wigand-mj/led-matrix/README.md

# led-matrix
Simple arduino controlled led matrix with snake game
