wigand-mj/led-matrix/schematics/EXPORT/MATRIX.PNG

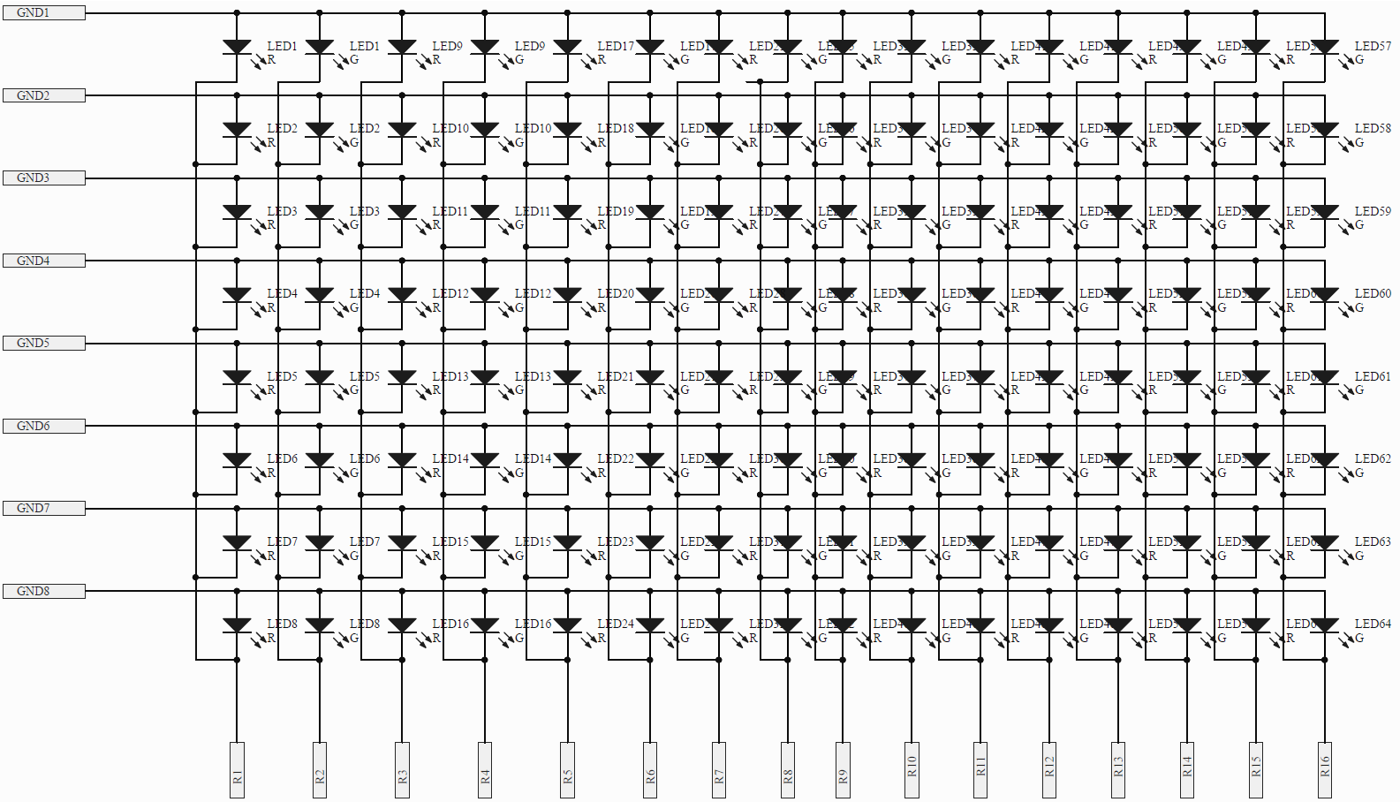
schematics/EXPORT/MATRIX.PNG
