wigand-mj/led-matrix/schematics/EXPORT/MATRIX_FIXED.PNG

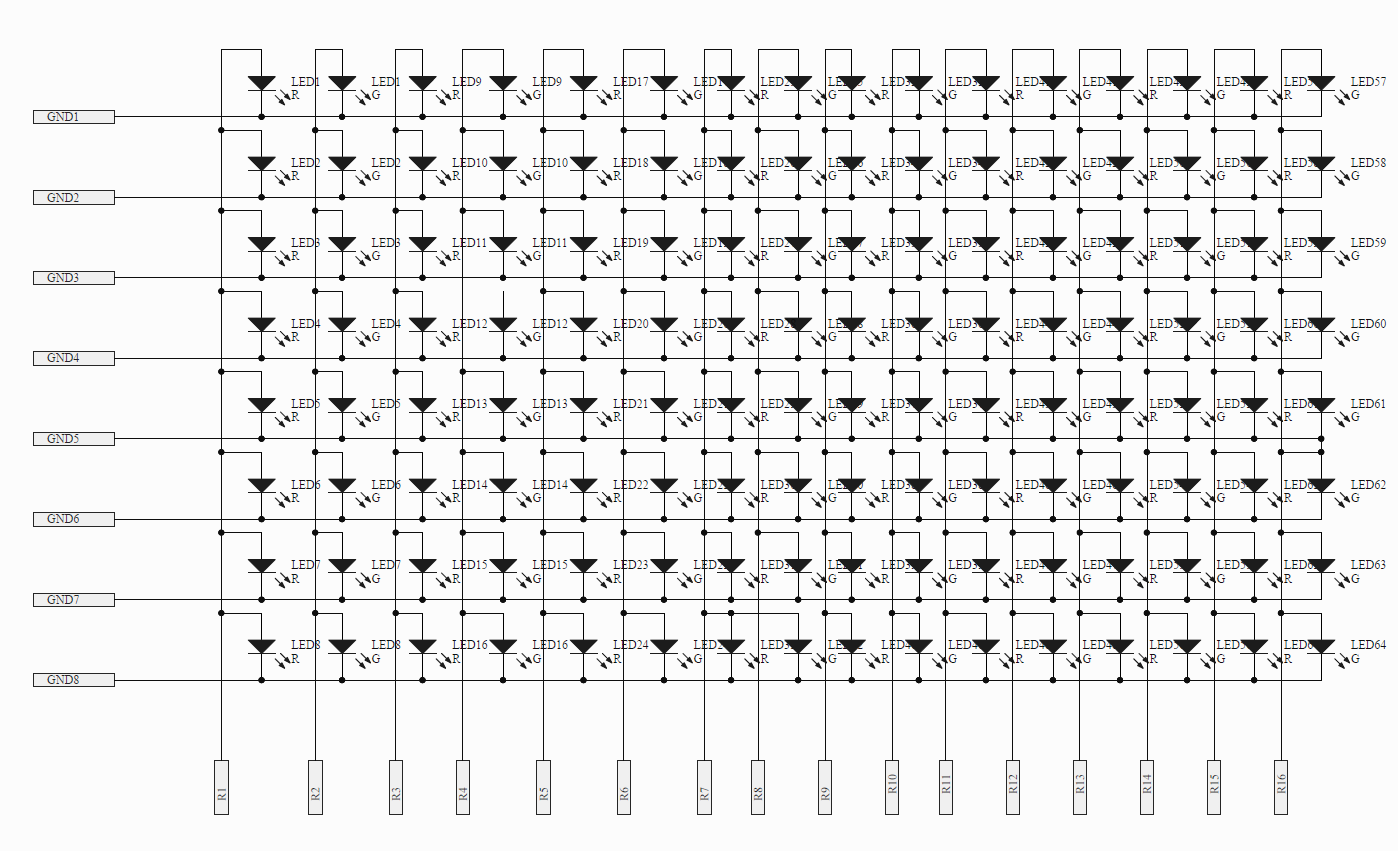
schematics/EXPORT/MATRIX_FIXED.PNG
