wigand-mj/led-matrix/schematics/LED_MATRIX_SCHEMATIC/Sheet1.pdf

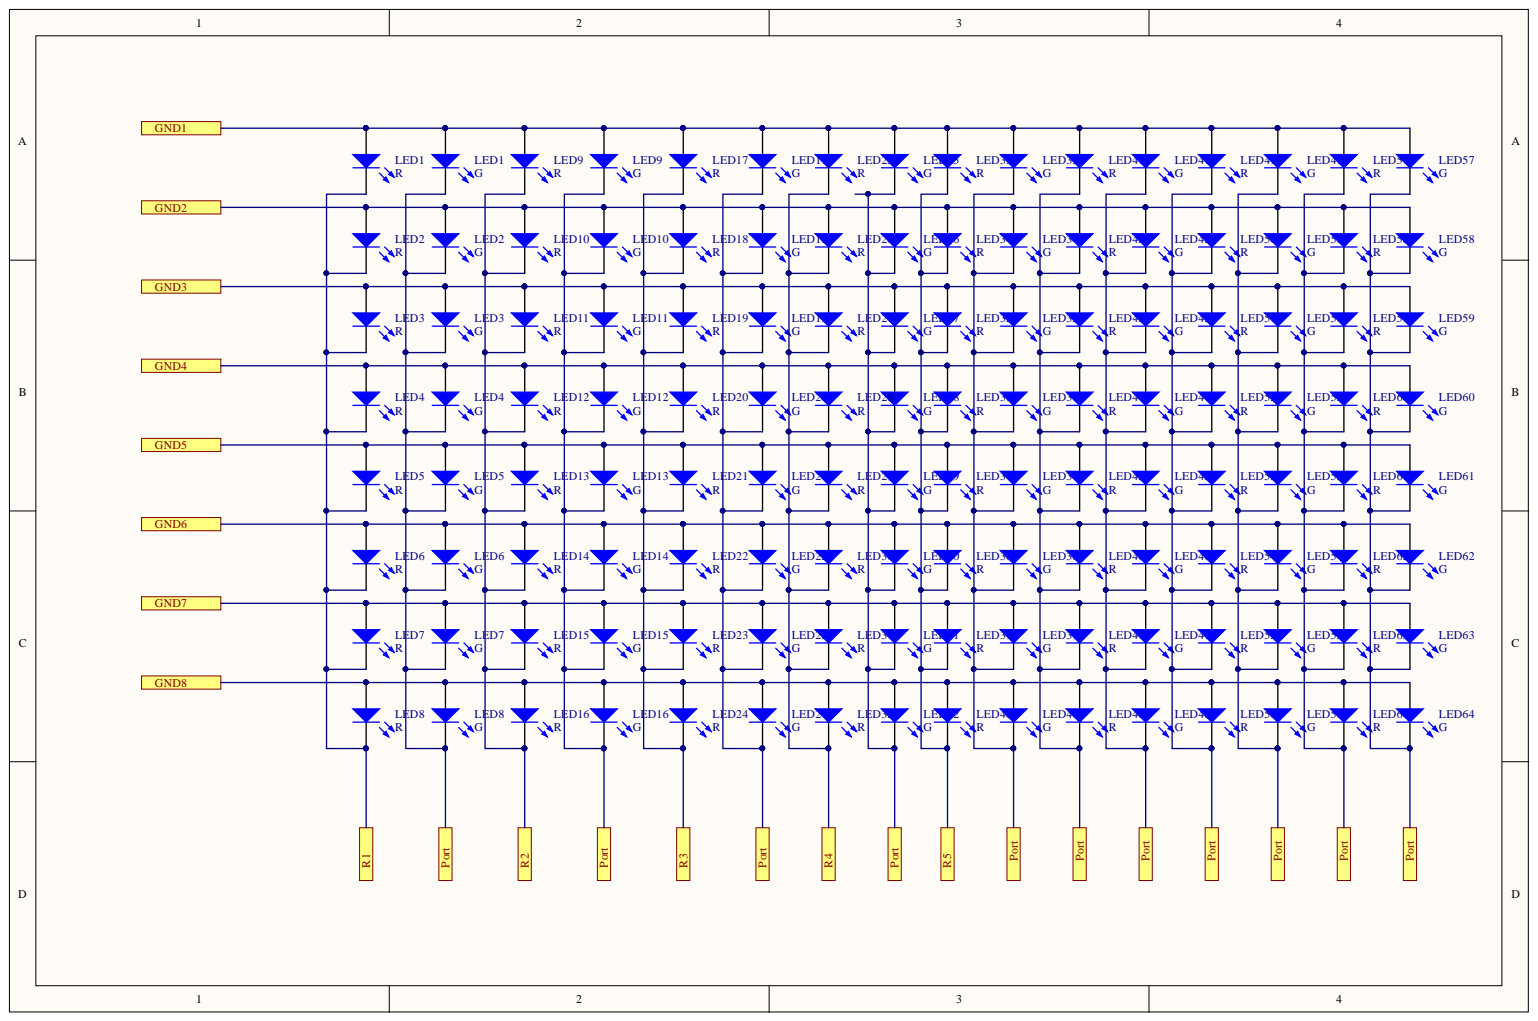
[picture p13: page 1]

# Board Stack Report
