wigand-mj/led-matrix/schematics/LED_MATRIX_SCHEMATIC/Sheet1_2.pdf

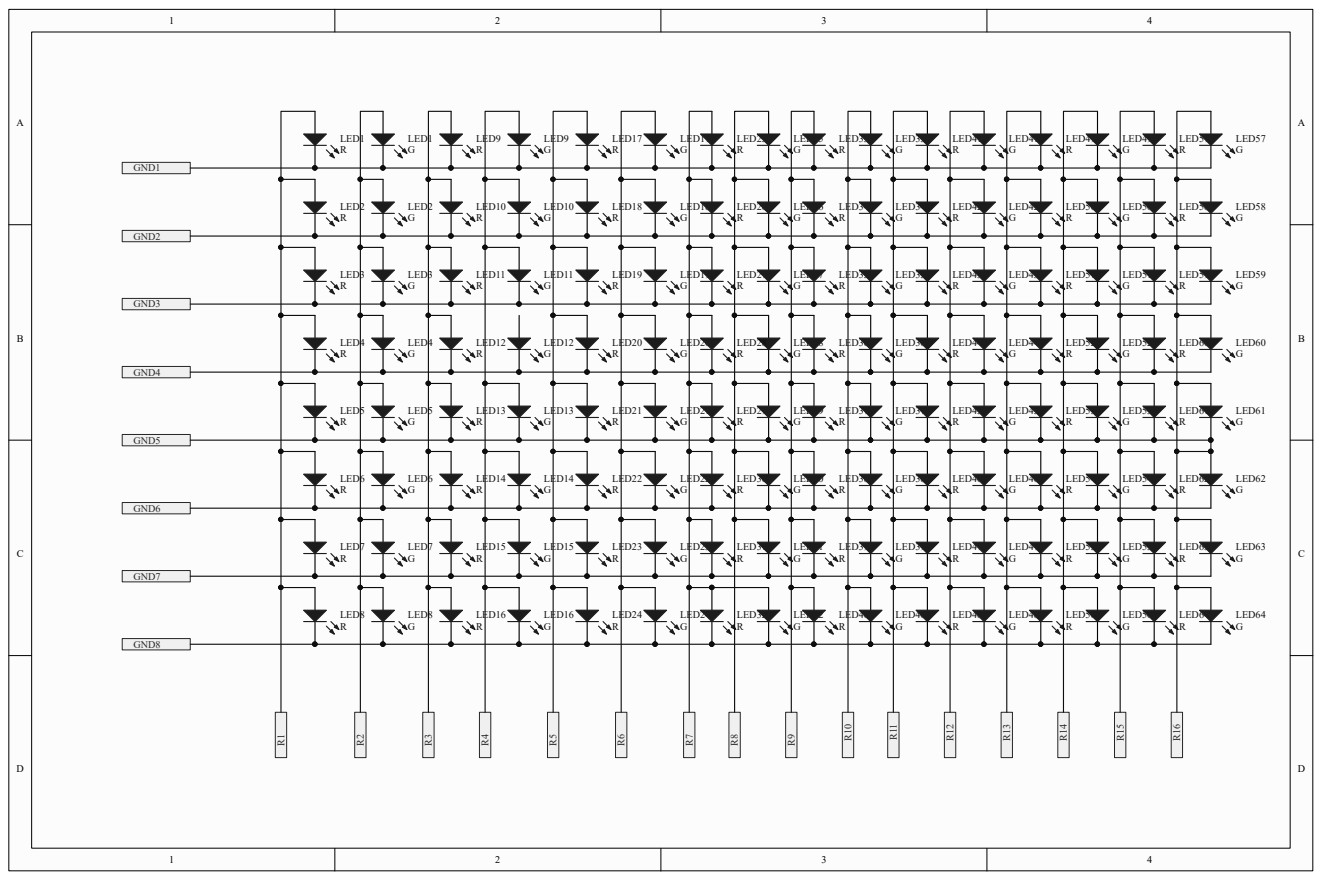
[picture p14: page 1]
