wigand-mj/led-matrix/schematics/LED_MATRIX_SCHEMATIC/pd.pdf

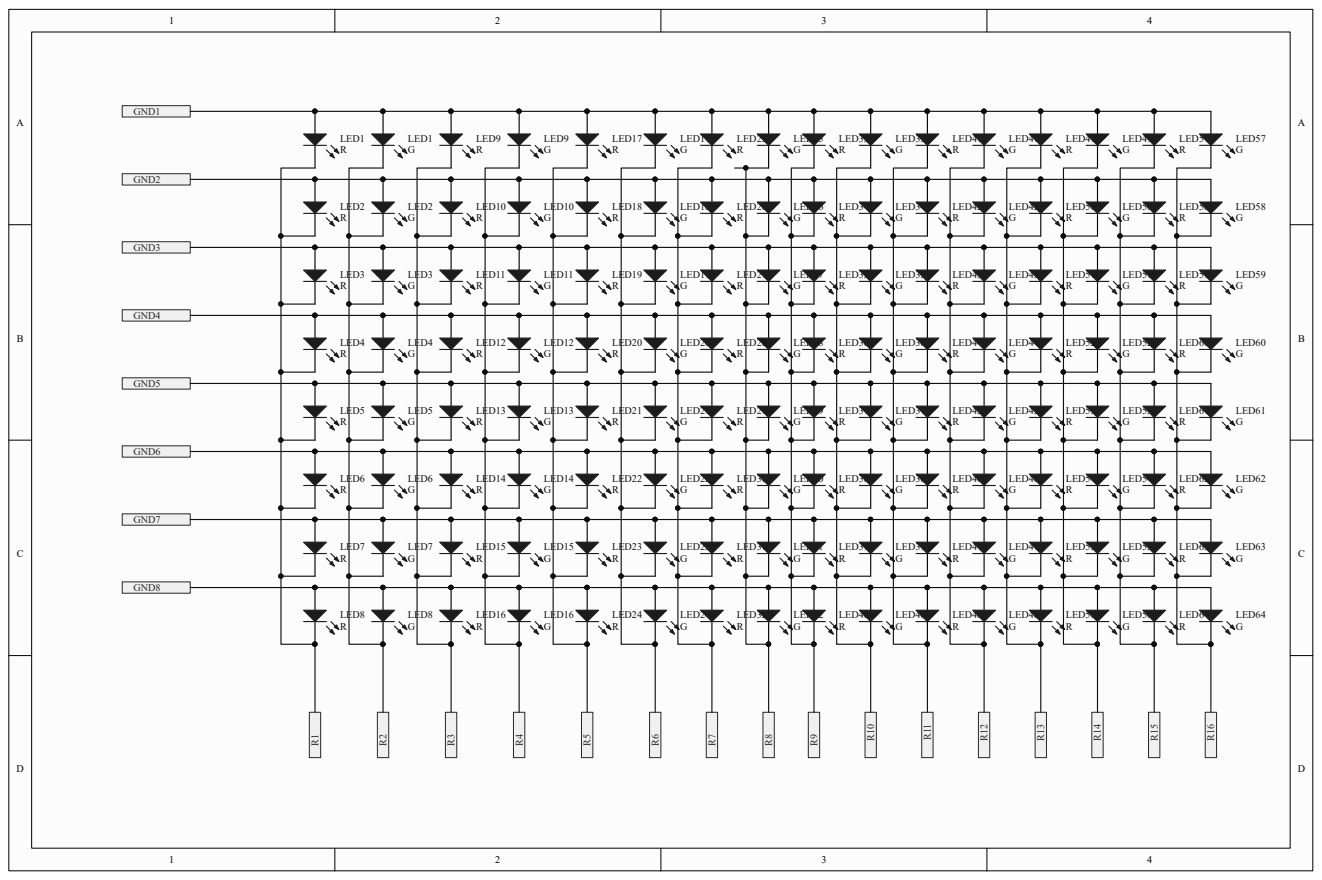
[picture p15: page 1]
