wigand-mj/led-matrix/(list of files, drawings)

Other design files:
schematics/LED_MATRIX_SCHEMATIC/LED_MATRIX_SCHEMATIC.PrjPcb
schematics/LED_MATRIX_SCHEMATIC/PCB1.PcbDoc
schematics/LED_MATRIX_SCHEMATIC/Sheet1.SchDoc
schematics/LED_MATRIX_SCHEMATIC/Sheet2.SchDoc
