wigand-mj/led-matrix/(commit log)

2020-02-03 Create Altium Project
    [LED_MATRIX_SCHEMATIC.PrjPcb, PCB1.PcbDoc, Sheet1.SchDoc]
2020-02-03 Schematic Test
    [Sheet1.SchDoc]
2020-02-03 Schematic Idea
    Common Anode vs Common Kathode
    [Sheet1.SchDoc]
2020-02-04 Auto stash before merge of "master" and "origin/master"
    [Sheet1.SchDoc]
2020-02-04 Matrix Schematic
    [Sheet1.SchDoc]
2020-02-04 Matrix Schematic Fix
    [Sheet1.SchDoc]
2020-02-04 More LED Matrix Schematic
    Still missing 2 Leds (1G, 1R)
    [Sheet1.SchDoc]
2020-02-06 control almost Works!
    A few weird problems still persist
    [main.cpp]
2020-02-07 baord.cpp & board.h
    board printing matrix
2020-02-09 Powerpoint
    (recycled)
2020-02-12 added comments to snake.cpp and board.cpp
2020-02-12 matrix schematic finish
    [Sheet1.SchDoc]
2020-02-12 More schematic stuff
    [LED_MATRIX_SCHEMATIC.PrjPcb, Sheet2.SchDoc]
2020-02-18 Schematic Update
    [Sheet1.SchDoc]
